sladek/EPROM_EMU_NG_FW_2708/README.md

# EPROM_EMU_NG_FW_2708

This is a modification of the original EPROM NG to handle also 1kB EPROMs 2708. The motivation for this project was the fact that I got an 8080 single-board microcomputer (SBC) from my brother. It is an SBC that was produced in Czechoslovakia in 1982 by a company named TESLA. Yes, TESLA! It was established in 1921 as Electra and renamed to TESLA in 1946, so it is quite older than America's Tesla. Even though a lot of stuff was just a copy of components from the west, it used to have quite high quality. One of the most successful products was the "school microcomputer" PMI-80, based on the 8080 CPU.

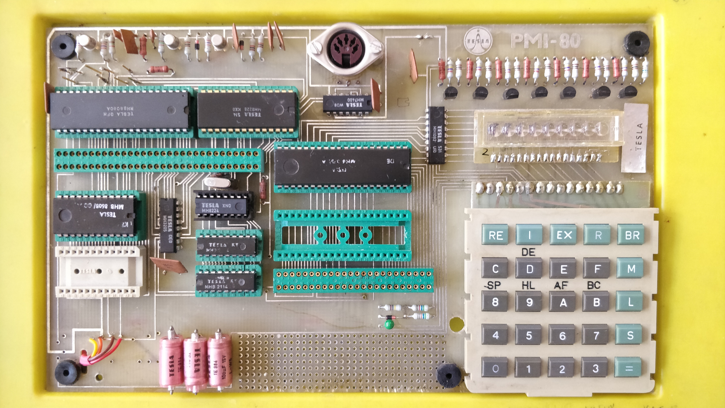
[picture p1: pictures/PMI-80.jpg]


PMI-80 

As you can see in the picture above, all the parts are produced by TESLA. To my surprise, one enthusiast from Slovakia created a clone of this SBC, and it is still available. You can see it here, the [PMI-80 replica](https://github.com/TomasPavlovicPavlo/PMI-80) replica. It is very well made and documented, so it is worth checking.

After I've made it work 

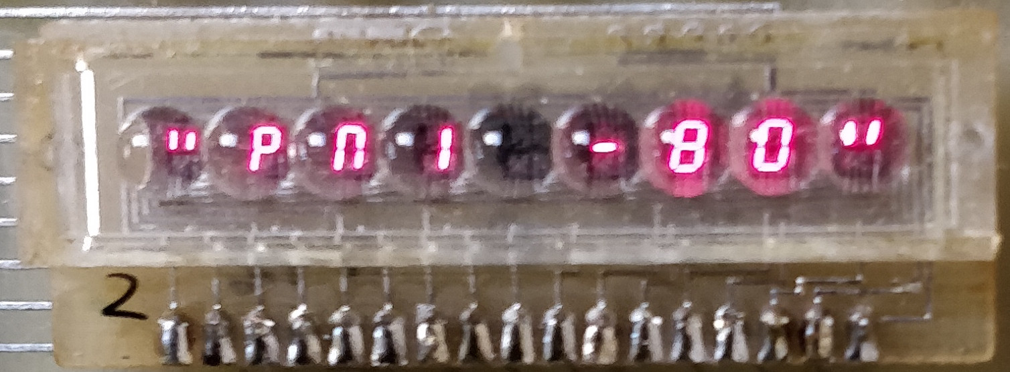
[picture p2: pictures/PMI-80-LED.jpg]


and played with it a bit I realized that typing a binary code from a keyboard is really not very pleasant, to say it mildly, so I was looking for some more convenient way to enter data into the memory of this SBC. As you can see from the picture above, there is one free position on the left side of the board, which is reserved for an additional EPROM. In this case the position is for an EPROM of type I2708, which has a size of 1 kB. So the easiest solution that came to my mind was using an EPROM emulator. After some googling, I found one that can be easily built and also supports memory 2716, which can be used also in this case for 2708, as it will not collide with anything above its memory range as there is nothing to be addressed on this board. But I also made some modifications to accommodate 2708 memories, which will be described later. The emulator can be seen here: [EPROM Emulator Project with Arduino](https://github.com/Kris-Sekula/EPROM-EMU-NG). You can also buy a PCB and populate it yourself on eBay, for example, here [Eprom Ng](https://www.ebay.de/sch/i.html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) or here [EPROM Emulator NG](https://www.ebay.co.uk/itm/116341805460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). So I bought a PCB and populated it myself.

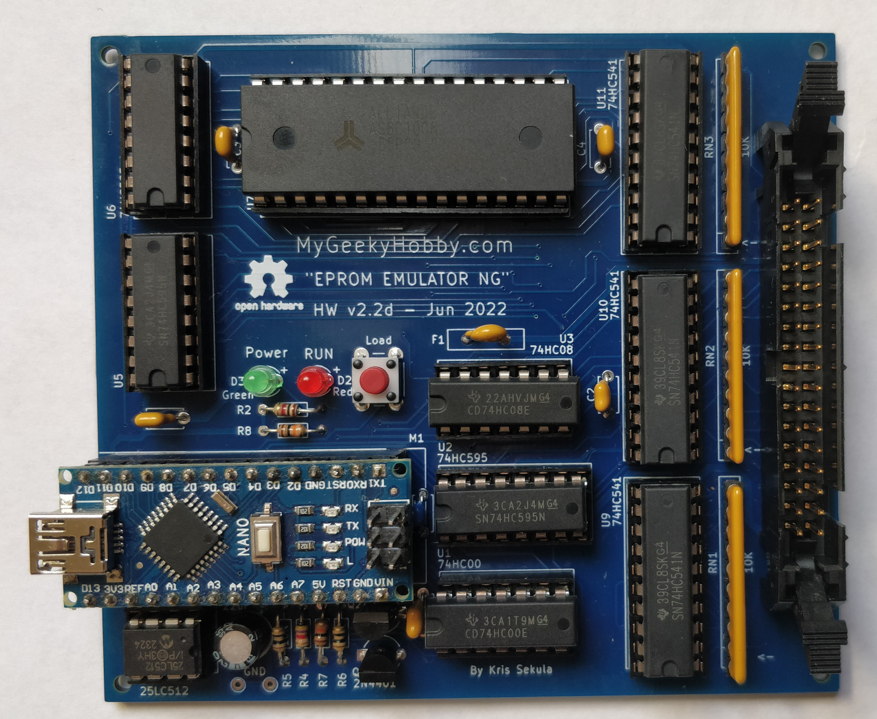
[picture p3: pictures/EPROM_EMU_2_2d.jpg]


EPROM EMULATOR 2.2d

The next challenge was a cable between the emulator and the PMI-80 EPROM socket.

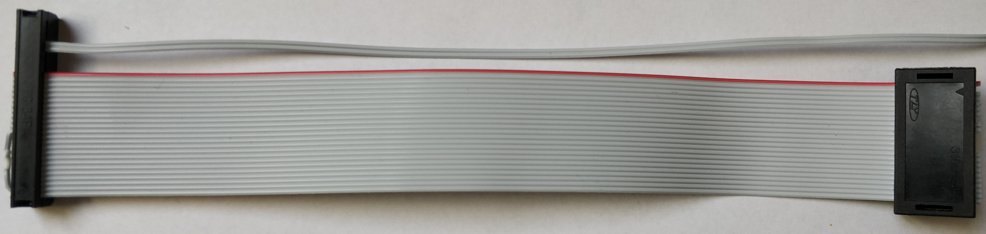
[picture p4: pictures/Cable_eprom_ng_2708.jpg]


Cable 2708

As you can see, I could make it, with some tricks, without any visible ugly cable crossing. The details of the cable construction are [here](hardware/README.md).

So now we are ready to use the emulator even with the original software, but as mentioned above, I've made some modifications so 2708 now can be selected from the GUI or via the command line. The modified software is [here](software).

When software is flashed to Arduino, we can connect the emulator to SBC. Below is a picture of PMI-80 connected to the emulator.

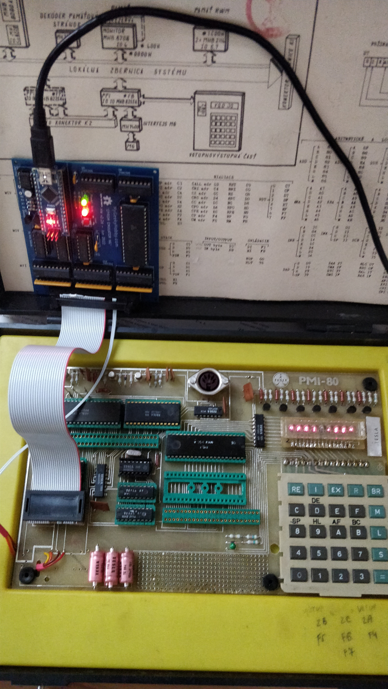
[picture p5: pictures/EMU_PMI-80.jpg]


EMU_NG connected to PMI-80

I've also included an example of source code that I used for testing the emulator. It is a slightly modified version of the example from the [PMI-80 replica](https://github.com/TomasPavlovicPavlo/PMI-80). The modified example is [here](examples).
