sladek/EPROM_EMU_NG_FW_2708/pictures/eprom_ng.jpg

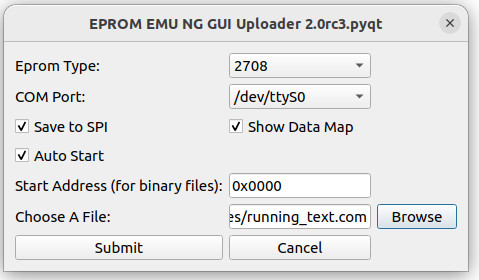
pictures/eprom_ng.jpg
