sladek/EPROM_EMU_NG_FW_2708/hardware/2708_probe.pdf

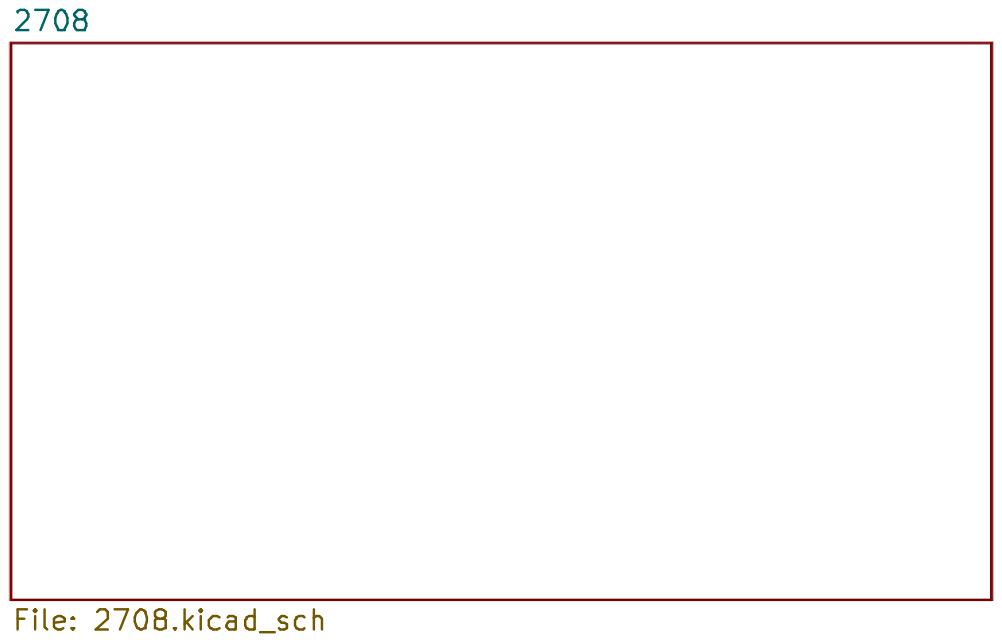
[picture p15: page 1]

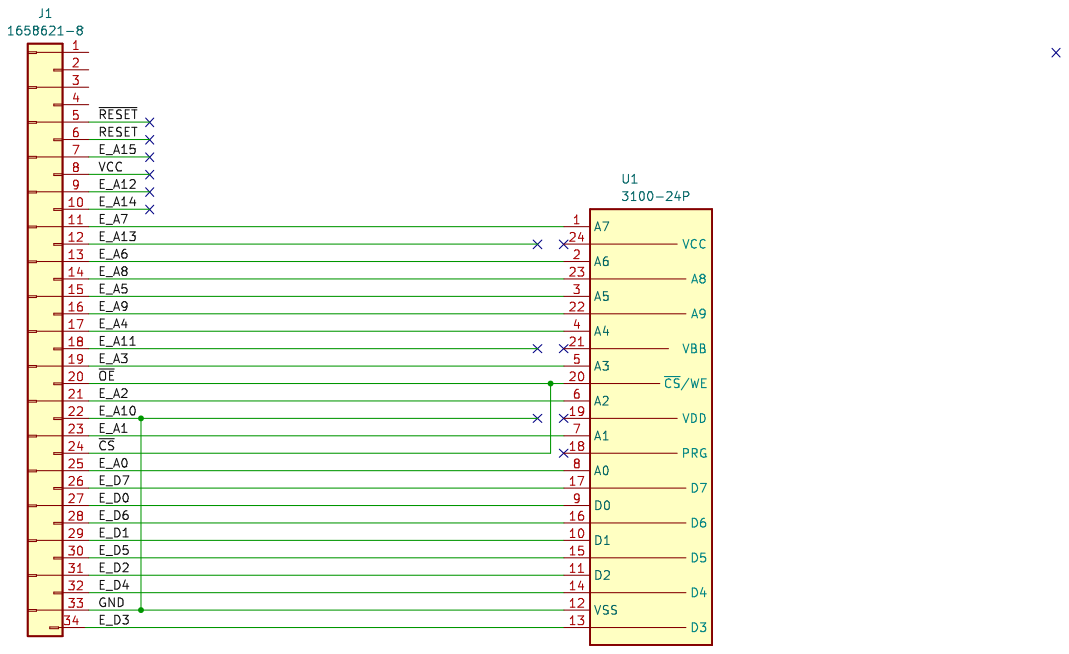
[picture p16: page 2]
